Ming874/bsis-radar/docs/PROTOCOL.md

# ESP32 ⇄ 網頁通訊協定（韌體 4.x）

ESP32 與網頁之間以**一行一筆的純文字**溝通：`鍵=值` 以空白分隔，每行以 `\n` 結尾。同一套指令也可以從 USB 序列埠（115200 bps）輸入，USB 端輸出的遙測與藍牙完全相同，可直接用同一套工具記錄與分析。

韌體實作：`firmware/SpeedRadar/src/comm/Telemetry.cpp`、`CommandParser.cpp`；網頁實作：`web/src/domain/protocol.ts`。

4.0 起兩顆雷達都是 HLK-LD2451：**測速雷達**斜照路面（取代 3.x 的 DFRobot C4001）、**後方雷達**朝正後方。3.x 與 4.x 的遙測、設定欄位不同，網頁 4.x 只支援韌體 4.x（主版本不同時會提示）。

## 1. 傳輸層：BLE Nordic UART Service

| 項目 | 值 |
| --- | --- |
| 裝置名稱 | `BSIS-Speed`（2.x 以前為 `RadarA-ESP32`） |
| Service | `6E400001-B5A3-F393-E0A9-E50E24DCCA9E` |
| RX（網頁 → ESP32，Write） | `6E400002-B5A3-F393-E0A9-E50E24DCCA9E` |
| TX（ESP32 → 網頁，Notify） | `6E400003-B5A3-F393-E0A9-E50E24DCCA9E` |
| MTU | ESP32 要求 247，實際值由手機決定 |

- ESP32 依協商到的 MTU 把一行切成多個通知（每段最多 MTU − 3 位元組，上限 180），網頁收到 `\n` 才組成一行。
- 一般藍牙序列 App（nRF Connect、Serial Bluetooth Terminal）也能連線並收發相同文字。
- 藍牙**沒有加密**。安裝與校正完成後，可將 `AppConfig.h` 的 `kAllowBleConfig` 改為 `false`：藍牙只能讀資料，修改參數必須經由 USB。

## 2. 遙測（ESP32 → 網頁）

測速雷達每送一個資料框就送一行；雷達沒有資料時每 250 ms 送一行心跳，心跳的 `FN` 不變。LD2451 有目標時連續輸出（頻率待實測，估計約 10 Hz），**沒有目標時約每 1.4 秒才送一個空資料框**。

```text
R=1 RO=0 ST=3 V=5.43 SD=0.12 Q=95 WD=0 FN=1234 N=3 A=-2 RD=2 RV=4.72 S=12 G=5.40 FV=0 DR=1234.5 W=5.51 DW=1240.2 T=812
```

| 欄位 | 意義 | 單位／格式 | 沒有資料時 |
| --- | --- | --- | --- |
| `R` | 測速雷達是否在線（ESP32 收得到 LD2451 的資料） | 0／1 | — |
| `RO` | 測速雷達只接收：指令沒有回覆（LD2451 RX 沒接到 GPIO17），偵測設定寫不進雷達 | 0／1 | `0` |
| `ST` | 估計器狀態，見 §2.1 | 0～5 | `0` |
| `V` | 對地速度（濾波後、已乘校正係數） | m/s，2 位小數 | `-1`（速度未知） |
| `SD` | `V` 的 1σ 不確定度（卡爾曼濾波的共變異數） | m/s | `0` |
| `Q` | 最近 20 個資料框中可用量測（採用）的比例 | % | `0` |
| `WD` | 最近 20 個資料框中「方向相反」的比例；持續偏高代表 `DIR` 可能設反 | % | `0` |
| `FN` | 資料框序號（開機起累計） | 整數 | — |
| `N` | 這個資料框的目標數（LD2451 最多 5 個「移動中」的目標） | 0～5 | `0` |
| `A` | 代表目標的水平角（0 = 視軸） | 度，整數 | `0` |
| `RD` | 代表目標的距離 | m，**整數** | `-1` |
| `RV` | 代表目標的徑向速度：**正 = 遠離雷達**（朝後安裝、往前騎時的路面） | m/s，2 位小數（雷達的解析度是 1 km/h） | `0` |
| `S` | 代表目標的訊噪比 | 整數 | `0` |
| `G` | 這個資料框換算的對地速度（濾波前；多個路面目標時是中位數） | m/s | `-1`（沒有換算） |
| `FV` | 這個資料框的判斷結果，見 §2.2 | 0～8 | `1` |
| `DR` | 雷達里程（開機起） | m，1 位小數 | — |
| `W` | 輪速感測器的速度（參考值） | m/s | 開機後沒收過脈衝時不送 |
| `DW` | 輪速感測器的里程（圈數 × 輪周長） | m | 同上 |
| `T` | ESP32 開機後經過的時間 | s | — |

**代表目標**：方向正確、在窗口內的目標取對地速度的中位數，那個目標就是代表（偶數個時取中間兩個的平均，代表目標是訊噪比較高的那個）；沒有的話依序是方向相反、靜止、窗口外的目標中訊噪比最高的（[ALGORITHM.md](ALGORITHM.md) §0.3）。

雷達離線（`R=0`）時 `ST=0`、`V=-1`、`RO=0`，不送過時的原始值；`W`／`DW` 與雷達無關，照常送出。最長的一行約 150 位元組，韌體緩衝區 176 位元組（單元測試會檢查）。

### 2.1 估計器狀態 `ST`

| 值 | 名稱 | 意義 | `V` |
| --- | --- | --- | --- |
| 0 | NoRadar | 雷達離線或尚未有資料 | `-1` |
| 1 | Stopped | 靜止 | `0` |
| 2 | Acquiring | 剛看到地面回波，確認中（1 秒內 3 筆一致才開始追蹤） | `0` |
| 3 | Tracking | 正常追蹤 | 估計值 |
| 4 | Holding | 短暫失去地面回波，沿用估計值（最多 2 秒） | 估計值 |
| 5 | Lost | 訊號中斷 | `-1` |

3.x 的 `6`（OverRange，超過 C4001 測速上限）在 4.0 拿掉：LD2451 可量到 120 km/h，不會折疊。

### 2.2 資料框判斷 `FV`

| 值 | 名稱 | 意義 |
| --- | --- | --- |
| 0 | Accepted | 採用，用來更新速度 |
| 1 | NoTarget | 雷達沒有回報目標 |
| 3 | OutOfGate | 目標都不在地面窗口內：距離超出窗口，或水平角超過 ±30° |
| 4 | WrongDirection | 窗口內的目標都和 `DIR` 預期的方向相反（後方來車，或 `DIR` 設反） |
| 5 | Static | 靜止回波（0 km/h），或停著時的微小晃動 |
| 7 | Outlier | 與目前估計相差超過 3σ 閘門 |
| 8 | Acquiring | 擷取階段的量測 |

`2`（Repeated，C4001 的外插資料框）、`6`（AtLimit，接近 `VMAX`）、`9`（Unfolded，折疊還原）是 3.x 才有的，4.0 不再出現。LD2451 的速度是整數 km/h，連續幾個資料框完全一樣很正常，不再當作外插。

### 2.3 後方來車（`REAR` 行，韌體 3.1 起）

後方 LD2451 的狀態另外一行，和上面的遙測分開送（每行都放得進一個藍牙通知）：有目標或警示中每 0.1 秒、沒有目標時每 0.5 秒、後方雷達離線時每 1 秒（`REAR ON=0`），**等級改變時立刻送**。`AppConfig.h` 的 `kPinRearRx = -1`（沒有後方雷達）時完全不送。

```text
REAR ON=1 RO=0 LV=1 D=12.4 V=4.17 TTC=3.0 HOLD=0 N=2 CNT=3 FN=812 X=-3/12/15,6/31/-40
```

| 欄位 | 意義 | 單位／格式 | 沒有資料時 |
| --- | --- | --- | --- |
| `ON` | 後方雷達在線（ESP32 收得到 LD2451 的資料框） | 0／1 | — |
| `RO` | 只接收：LD2451 不回應指令（RX 沒接），偵測設定沒寫進雷達 | 0／1 | `0` |
| `LV` | 警示等級：0 安全、1 注意、2 危險（[REAR_RADAR.md](REAR_RADAR.md) §5） | 0～2 | `0` |
| `D` | 主要來車的距離（濾波後） | m，1 位小數 | `-1` |
| `V` | 主要來車的接近速度（都卜勒） | m/s，2 位小數 | `0` |
| `TTC` | 主要來車的到達時間 | s，1 位小數 | `-1` |
| `HOLD` | 警示保持中：來車已不在雷達視野（正在旁邊超車，或停下來了） | 0／1 | `0` |
| `N` | 這個資料框的目標數（LD2451 最多 5 個） | 0～5 | `0` |
| `CNT` | ESP32 開機後的警示次數（安全 → 注意／危險算一次），網頁用差值算每趟行程的次數 | 整數 | — |
| `FN` | 後方雷達資料框序號（開機起） | 整數 | — |
| `X` | 這個資料框的每個目標：`角度/距離/速度`，以逗號分隔。角度 °（0 = 正後方）、距離 m、速度 km/h（**正 = 靠近、負 = 遠離**） | 整數 | 沒有目標時不送 |

`ON=0` 時只有這一個欄位。LD2451 的距離、速度、角度都是整數（雷達本身的解析度）。最長的一行約 150 位元組。注意 `REAR` 的 `X` 速度是「正 = 靠近」，主遙測的 `RV` 是「正 = 遠離」：兩者各自沿用 3.x 的定義。

## 3. 設定（ESP32 → 網頁）

回應 `GET`，以及每次設定成功後主動廣播一次：

```text
CFG ANGLE=30.0 HEIGHT=0.70 DIR=1 MODEL=0 CAL=1.0000 GSNR=4 WHEEL=2105 RMIN=0.71 RMAX=8.13 RANGE=15 RSPD=5 TTC=2.5 RSNR=4 RDET=25 FW=4.0.0
```

| 欄位 | 指令 | 意義 | 範圍 | 預設 |
| --- | --- | --- | --- | --- |
| `ANGLE` | `ANGLE <度>` | 測速雷達視軸的俯角（與水平面的夾角） | 10～75 | 30 |
| `HEIGHT` | `HEIGHT <m>` | 測速雷達天線面中心的離地高度 | 0.15～1.50 | 0.70 |
| `DIR` | `DIR 1\|-1` | 雷達朝向：`1` 朝後（往前騎時地面遠離）、`-1` 朝前 | 1／-1 | 1 |
| `MODEL` | `MODEL 0\|1` | 速度模型：`0` 固定角度、`1` 距離幾何（[ALGORITHM.md](ALGORITHM.md) §0.4） | 0／1 | 0 |
| `CAL` | `CAL <係數>` | 校正係數，速度與里程都乘上它 | 0.5～2.0，4 位小數 | 1.0000 |
| `GSNR` | `GSNR <n>` | 測速雷達（LD2451）的訊噪比門檻，越大越不靈敏（寫進雷達） | 3～8 的整數 | 4 |
| `WHEEL` | `WHEEL <mm>` | 輪周長，只用於輪速感測器（參考值） | 1000～3000 的整數 | 2105 |
| `RMIN`／`RMAX` | — | 由 `ANGLE`、`HEIGHT` 算出的地面距離窗口（唯讀）；LD2451 的距離是整數，韌體實際用 ⌊`RMIN`⌋～⌈`RMAX`⌉ | m | — |
| `RANGE` | `RANGE <m>` | 後方來車警示距離：確認的來車在這個距離內 → 注意 | 5～50 的整數 | 15 |
| `RSPD` | `RSPD <km/h>` | 後方來車最低接近速度（寫進後方 LD2451，ESP32 也再篩一次） | 1～30 的整數 | 5 |
| `TTC` | `TTC <s>` | 到達時間 ≤ TTC（或距離 ≤ 5 m）→ 危險 | 1.0～6.0，1 位小數 | 2.5 |
| `RSNR` | `RSNR <n>` | 後方 LD2451 的訊噪比門檻，越大越不靈敏（寫進雷達） | 3～8 的整數 | 4 |
| `RDET` | — | 寫進後方 LD2451 的最大偵測距離 = `RANGE` + 10（10～100，唯讀） | m | 25 |
| `FW` | — | 韌體版本 | — | — |

寫進測速雷達的其他偵測設定是固定的：最大距離 10 m（可設定的最小值）、**靠近遠離都回報**（方向由 ESP32 依 `DIR` 判斷，設反時網頁才看得出來）、最低速度 1 km/h、延遲 1 s、累計觸發 1 次。

- 參數存在 ESP32 的 NVS（命名空間 `speedRadar`），斷電不會消失。對地測速欄位的版本：4.0 是 `ver=2`。從 3.x（`ver=1`，C4001）升級時沿用 `ANGLE`、`HEIGHT`、`DIR`、`WHEEL`；`CAL` 回到 1（換了雷達要重新校正），`MODEL`、`GSNR` 用預設值，C4001 的 `RTHR`、`VMAX` 在下次存檔時刪除。後方來車參數（3.1 新增）另外記版本，不受影響。
- 修改 `GSNR` 時 ESP32 會重新寫入測速雷達；修改 `RANGE`、`RSPD`、`RSNR` 時重新寫入後方雷達（各約 1 秒內沒有資料框）。只接收模式（`RO=1`）寫不進去。改 `ANGLE`、`HEIGHT` 只影響 ESP32 的換算與窗口，不必重寫雷達。
- 沒有 `RANGE` 的 `CFG` 是 3.0 的韌體（沒有後方雷達功能）。

## 4. 指令（網頁 → ESP32）

一行一個指令，大小寫不拘，數值可用空白、`=` 或 `:` 分隔，以 `\n` 結尾。

| 指令 | 作用 |
| --- | --- |
| `GET` | 回傳一行 `CFG` |
| `ANGLE 30`、`HEIGHT 0.7`、`DIR -1`、`MODEL 1`、`CAL 1.0425`、`GSNR 4`、`WHEEL 2105` | 修改單一參數（對地測速） |
| `RANGE 15`、`RSPD 5`、`TTC 2.5`、`RSNR 4` | 修改單一參數（後方來車） |
| `DEFAULTS` | 所有參數恢復預設值 |
| `REBOOT` | 重新啟動 ESP32 |
| `HELP` 或 `?` | 列出所有指令 |

3.x 的 `RTHR`、`VMAX` 在 4.0 回覆 `ERR unknown command`。

### 指令回覆

| 回覆 | 時機 |
| --- | --- |
| `OK saved` | 設定成功並已存檔，接著廣播一行 `CFG` |
| `OK applied (flash save failed)` | 已生效，但寫入快閃記憶體失敗（重開機會還原） |
| `OK reboot` | 收到 `REBOOT`，約 0.2 秒後重新開機 |
| `OK commands: …` | `HELP` 的指令列表 |
| `ERR <參數> must be <範圍>` | 數值超出範圍或格式錯誤（例如 `ERR ANGLE must be 10-75 (deg)`） |
| `ERR missing or bad value` | 缺少數值，或數值後面有多餘文字 |
| `ERR settings over Bluetooth are disabled, use USB` | `kAllowBleConfig = false` 時從藍牙修改參數 |
| `ERR unknown command, try HELP` | 不認得的指令 |

## 5. 解析規則

- 以空白切成 `鍵=值`；**不認得的鍵直接忽略**，之後新增欄位不會破壞舊的接收端。
- 同一行出現重複的鍵代表兩行被黏在一起（藍牙分段遺失），整行丟棄。
- 數值一律使用小數點、不含單位；`-1` 代表「沒有資料」（`V`、`RD`、`G`）。
- 開頭為 `CFG` 的是設定，`REAR` 是後方來車，`OK`／`ERR` 是指令回覆，其他含 `R`、`ST`、`V` 的是遙測。
- 判斷韌體世代：`CFG` 含 `TEST=`、`MINSPD=` 的是 2.x（後方來車偵測版），網頁會提示更新韌體；`FW` 的主版本與網頁不同（例如 3.x 的 C4001 版）時網頁也會提示。

## 6. CSV 紀錄格式（網頁「數據 → 記錄 CSV」）

每一個新的資料框一列（心跳行不重複記錄），UTF-8 含 BOM，Excel 可直接開啟。欄位與遙測一一對應：

```text
time_iso,uptime_s,frame,radar_online,state,speed_mps,sigma_mps,quality_pct,targets,angle_deg,range_m,radial_mps,snr,ground_mps,verdict,radar_distance_m,wheel_mps,wheel_distance_m,rear_online,rear_level,rear_distance_m,rear_closing_mps,rear_ttc_s,rear_targets
```

`state` 與 `verdict` 以名稱表示（`tracking`、`accepted`…）。`angle_deg`、`range_m`、`radial_mps`、`snr` 是代表目標（§2）。網頁 3.x 的 CSV 在 `radial_mps` 後面是 C4001 的 `energy`，4.0 改成 `snr`，並在 `range_m` 前面多了 `angle_deg`。`rear_*` 是那一刻最新的 `REAR` 行（網頁 3.1 起）：`rear_level` 為 `safe`／`caution`／`danger`，`rear_targets` 是以空白分隔的 `角度/距離/速度`。分析工具：[`firmware/diagnostics/analyze_ride.py`](../firmware/diagnostics/README.md)。

## 7. 網頁的匯出檔

這兩種檔案只在網頁產生，不經過 ESP32。

**行程紀錄**（「行程」頁的匯出，CSV，UTF-8 含 BOM）：一筆行程一列。

```text
start_iso,end_iso,distance_m,moving_s,elapsed_s,avg_kmh,max_kmh,overspeed_count,overspeed_s,limit_kmh,wheel_distance_m,rear_alerts
```

`avg_kmh` 是里程 ÷ 移動時間；沒有的欄位留空（網頁 2.1 以前的行程沒有超速，3.0 以前沒有 `limit_kmh`，3.1 以前沒有 `rear_alerts`）。

**一筆行程的速度曲線**（行程詳情的匯出，CSV）：`elapsed_s,speed_kmh`。每一格是那段時間的平均速度，間隔從 1 秒開始，點數到 900 時兩兩合併、間隔加倍（一小時的行程是 4 秒一格）；藍牙中斷的那幾格留空。

**備份檔**（「設定 → 資料 → 匯出備份」，JSON）：

```json
{ "app": "bsis-speed", "version": 1, "exportedAt": 1792000000000, "webVersion": "4.0.0",
  "settings": { "speedUnit": "kmh", "speedLimitKmh": 25, "...": "..." },
  "trips": [ { "id": "…", "startedAt": 0, "endedAt": 0, "distanceM": 0, "movingS": 0, "maxMps": 0, "rearAlerts": 3, "trace": { "stepS": 1, "v": [512, -1, 530] } } ] }
```

`trace.v` 是 cm/s 的整數，`-1` 代表那一格沒有資料。匯入時逐筆檢查：格式不對的行程略過；設定只取認得的欄位；行程依 `id` 合併，不會重複。網頁 3.1 以前的備份檔另有 `calibration`（校正紀錄），3.2 起網頁不做校正，匯入時忽略。
