Ming874/bsis-radar/firmware/release/VERSION.txt

BSIS SpeedRadar v4.0.0
built   : 2026-11-11 19:45
board   : esp32:esp32:esp32 (ESP32 Dev Module)
flash   : bootloader.bin@0x1000 partitions.bin@0x8000 boot_app0.bin@0xe000 firmware.bin@0x10000
sha256  : 0d4cd2b93d181d13e13b93b3a1d2856e8062967ea8cf7ff9ffbece83a566587c (firmware.bin)
