Ming874/bsis-radar/docs/images/desktop-device.png

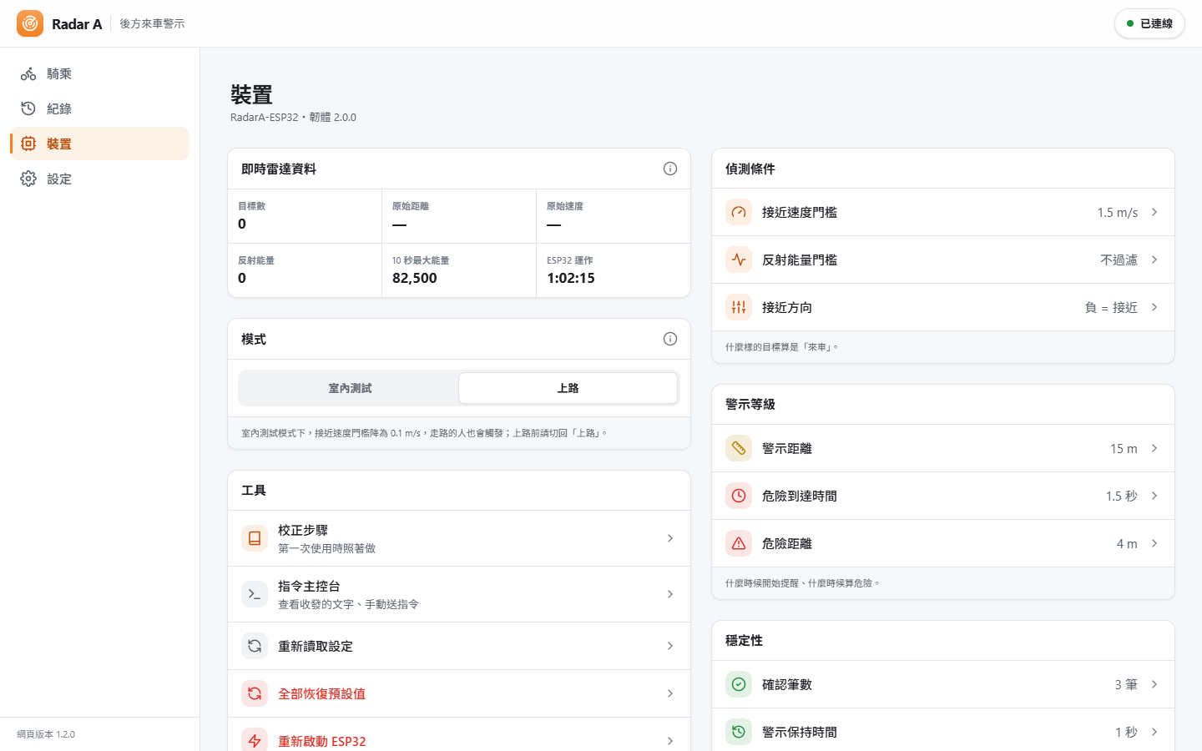
docs/images/desktop-device.png
