Ming874/bsis-radar/docs/images/desktop-ride.png

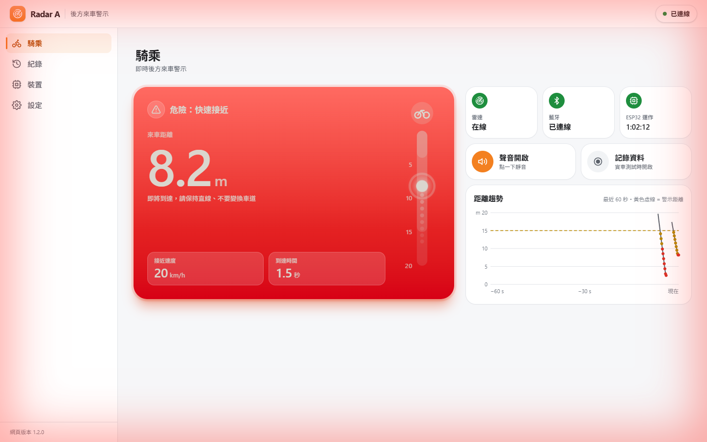
docs/images/desktop-ride.png
