Ming874/bsis-radar/docs/images/phone-caution.png

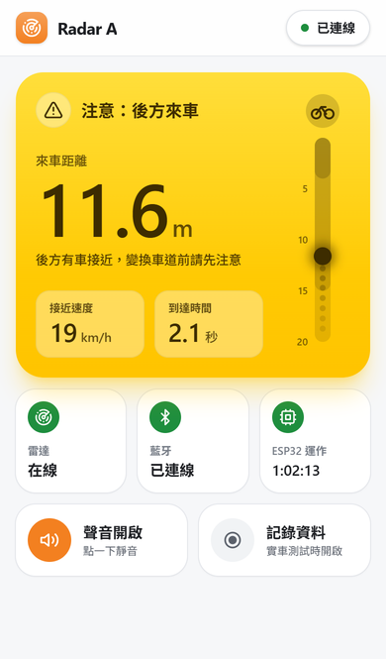
docs/images/phone-caution.png
