Ming874/bsis-radar/docs/images/phone-danger-dark.png

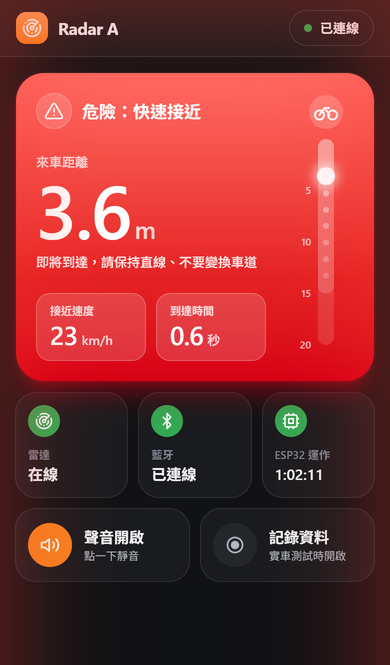
docs/images/phone-danger-dark.png
