Ming874/bsis-radar/docs/images/phone-danger.png

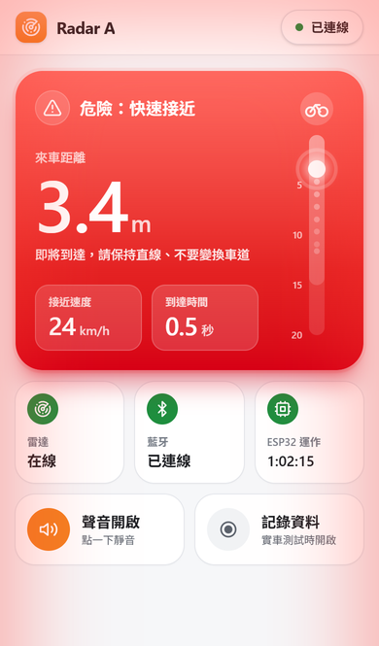
docs/images/phone-danger.png
