Ming874/bsis-radar/firmware/SpeedRadar/src/comm/Telemetry.h

/*!
 * @file   Telemetry.h
 * @brief  【通訊層】傳給網頁的文字格式（純 C++，可單元測試）。完整欄位定義見 docs/PROTOCOL.md。
 *
 * 遙測：測速雷達每一個資料框送一行；雷達沒有資料時每 250 ms 送一行心跳（FN 不變）。
 *   R=1 RO=0 ST=3 V=5.43 SD=0.12 Q=95 WD=0 FN=1234 N=3 A=-2 RD=2 RV=4.72 S=12 G=5.40 FV=0 DR=1234.5 W=5.51 DW=1240.2 T=812
 *   R  測速雷達在線    RO 測速雷達只接收（指令沒有回覆，偵測設定沒寫進雷達）
 *   ST 估計器狀態（SpeedState）   V 對地速度 m/s（未知 -1）   SD 1σ 不確定度 m/s
 *   Q  最近 20 筆可用量測比例 %   WD 最近 20 筆方向相反的比例 %   FN 資料框序號
 *   N  這個資料框的目標數
 *   A/RD/RV/S 代表目標的水平角° / 距離 m（整數） / 徑向速度 m/s（正 = 遠離雷達） / 訊噪比（沒有目標時 0 / -1 / 0 / 0）
 *   G  這個資料框換算的對地速度（濾波前，沒算 -1）   FV 這個資料框的判斷（FrameVerdict）
 *   DR 雷達里程 m（開機起）   W/DW 輪速感測器的速度 m/s / 里程 m（收過脈衝才送）   T 開機秒數
 *
 * 後方來車（HLK-LD2451，另外一行；有目標或警示中每 0.1 秒、平常每 0.5 秒、等級改變時立刻送）：
 *   REAR ON=1 RO=0 LV=1 D=12.4 V=4.17 TTC=3.0 HOLD=0 N=2 CNT=3 FN=812 X=-3/12/15,6/31/40
 *   ON 雷達在線   RO 只接收（指令沒有回覆，設定沒寫進雷達）   LV 警示等級（RearLevel）
 *   D/V/TTC 主要來車的距離 m / 接近速度 m/s / 到達時間 s（沒有為 -1 / 0 / -1）   HOLD 警示保持中
 *   N 這個資料框的目標數   CNT 開機後的警示次數   FN 後方雷達資料框序號
 *   X 這個資料框的目標：角度°/距離 m/速度 km/h（正 = 靠近、負 = 遠離），以逗號分隔（沒有目標時不送）
 *
 * 設定：CFG ANGLE=30.0 HEIGHT=0.70 DIR=1 MODEL=0 CAL=1.0000 GSNR=4 WHEEL=2105 RMIN=0.71 RMAX=8.13
 *           RANGE=15 RSPD=5 TTC=2.5 RSNR=4 RDET=25 FW=4.0.0（實際是一行）
 *   RMIN/RMAX 是由 ANGLE、HEIGHT 算出的地面距離窗口、RDET 是寫進後方 LD2451 的偵測距離（RANGE + 10），都是唯讀
 *
 * 每行以 '\n' 結尾；藍牙依 MTU 分段送出，網頁端收到 '\n' 才算一行。最長的一行也放得進一個通知（單元測試會檢查）。
 */
#pragma once
#include <stddef.h>
#include <stdint.h>

#include "../core/GroundSpeedEstimator.h"
#include "../core/RadarFrame.h"
#include "../core/RearThreat.h"
#include "../core/SpeedConfig.h"

// 一行文字的緩衝區大小（含結尾 '\n' 與 '\0'）；單元測試會檢查最長的情況放得下
constexpr size_t kTelemetryLineMax = 176;
constexpr size_t kConfigLineMax    = 176;
constexpr size_t kRearLineMax      = 176;

struct TelemetrySnapshot {
  bool        radarOnline  = false;
  bool        receiveOnly  = false;  // 測速雷達只接了 TX：偵測設定寫不進去
  SpeedState  state        = SpeedState::NoRadar;
  bool        hasSpeed     = false;
  float       speedMps     = 0.0f;
  float       sigmaMps     = 0.0f;
  uint8_t     qualityPct   = 0;
  uint8_t     wrongDirPct  = 0;
  uint32_t    frame        = 0;      // 資料框序號（心跳時不變，網頁用來去除重複）
  bool        hasFrame     = false;  // 有沒有最新一個資料框
  RadarFrame  raw;
  FrameResult result;
  double      radarDistanceM = 0.0;
  bool        hasWheel       = false;  // 有接輪速感測器（開機後收過脈衝）
  float       wheelMps       = 0.0f;
  double      wheelDistanceM = 0.0;
  uint32_t    uptimeS        = 0;
};

struct RearSnapshot {
  bool       online      = false;
  bool       receiveOnly = false;
  RearState  state;
  uint32_t   frame    = 0;      // 後方雷達資料框序號
  bool       hasFrame = false;  // 有沒有最新（1 秒內）的資料框
  RadarFrame raw;
};

// 回傳寫入的字元數（含結尾 '\n'），空間不足時回傳 0
size_t formatTelemetry(const TelemetrySnapshot& s, char* out, size_t cap);
size_t formatRear(const RearSnapshot& s, char* out, size_t cap);
size_t formatConfig(const SpeedConfig& c, const char* firmwareVersion, char* out, size_t cap);
