Ming874/bsis-radar/(commit log)

2026-10-03 Radar A 後方來車偵測：ESP32 韌體與網頁
    - 韌體 v2.0.0：非阻塞 C4001 驅動、來車確認與 TTC 分級、BLE NUS、NVS 設定、一鍵燒錄 flash.bat
    - 網頁 v1.2.0：React + TypeScript + Vite，白底橘色主題、iOS 風格警示卡、手機／電腦版自動切換
    - 文件：上手文件、通訊協定、韌體與網頁說明
2026-10-03 部署改為 GitHub 自動更新：push 到 main 由 Zeabur 自動建置 web/
2026-10-03 網頁預設改為深色主題
    - 預設主題改為深色（設定存放名稱改為 radarA.settings.v3，舊的偏好不沿用）
    - index.html 在畫面出現前就套用主題，網址列顏色同步
    - 設定頁外觀選項把「深色」放第一個
2026-10-03 韌體 v2.1.0：都卜勒 × 距離變化率交叉核對的來車速度演算法
    - 卡爾曼濾波器（距離、距離變化率）融合雷達距離與都卜勒速度，取代原本的 α 濾波
    - 以最近 1 秒距離的最小平方斜率核對都卜勒：超過 10 m/s 的折疊自動還原、SIGN 設反自動修正並提示、
    速度飽和或不一致時改用距離變化率；具遲滯與正負號鎖定，避免誤判
    - 驗證閘門依卡爾曼不確定度調整；連續 3 筆彼此一致的跳值才換目標，反射點亂跳不會帶偏追蹤
    - 遙測新增 VS（速度來源）與 RR（距離變化率）；序列埠除錯輸出同步顯示
    - 單元測試 173 項（新增折疊、飽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
    [AppConfig.h, Telemetry.cpp, Telemetry.h]
2026-10-03 修正 CLAUDE.md 的指令文字
2026-10-15 韌體 v2.2.0：依 C4001 實測修正偵測不穩（雷達門檻 30 → 5）
    用 USB ↔ 雷達直通程式實測 C4001（10 Hz、室內、人坐在雷達前 0.5～1 m）找到的問題：
    - setThrFactor 一直用 30，但 UART 的數字就是門檻本身（讀回 30.00），原廠預設是 5：
    門檻 30 時 30 秒只有 4% 的資料有目標（而且是 3.2 m 外風扇的雜訊），5／10／15 都是 100%，
    逐筆距離變化 1.2～4.2 cm。雷達門檻改成執行期參數 RTHR（1～50，預設 5），網頁可調
    - 能量中位數把「0 個目標」算成 0：目標斷斷續續時中位數變 0，設了 MINE 就確認不了來車；
    現在只統計追蹤中目標的偵測，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
2026-10-15 新增 C4001 診斷工具（firmware/diagnostics）
    - C4001Bridge：USB ⇄ C4001 直通程式，可直接下指令、記錄每一筆原始資料框（ALGORITHM.md §10 的實測方法）
    - bridge.ps1／analyze.awk：送指令並記錄、統計偵測率、外插資料框與距離／速度／能量
    - guided_test.ps1：搭配正式韌體，用中文語音引導走動測試，逐輪比較不同的 RTHR
2026-10-15 網址改為 bsis.mingchen.dev
    網頁、flash.ps1 的提示、README、上手文件與 CLAUDE.md 的正式網址從 bsis.iosoftware.ai 改成 bsis.mingchen.dev。
2026-10-15 文件：走動測試結果（雷達門檻 5／15／30）
    語音引導走動測試：門檻 5 走動時偵測率 100%、距離沒有跳動；15 為 96.7%、跳動 4 次；
    舊版 30 只有 76.8%、跳動 14 次（最遠跳到 6.9 m）。
2026-10-15 韌體 v2.3.0／網頁 v1.5.0：沒有來車時也顯示雷達追蹤中的目標
    人站在雷達前面不動時，雷達其實一直追蹤得到（實測 64 筆有 63 筆），但網頁只顯示
    「確認正在接近的來車」，所以看起來只偵測到一下下就跳回安全，卡片還寫「後方淨空」。
    - 遙測新增 TD／TV：雷達目前追蹤的目標距離與接近速度（濾波後，不論是不是來車；沒有追蹤時不送）
    - 騎乘頁：安全時卡片下方顯示「偵測到目標 2.9 m・靜止／接近／遠離」，雷達條上畫空心圈；
    大數字與警示仍然只給確認的來車
    - 裝置頁：即時雷達資料加入「追蹤距離」「追蹤速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
2026-10-15 更正：正對雷達的牆會被回報成靜止目標
    實測雷達朝著約 2.9 m 外的牆、前方沒有人時，一直回報 2.86 m、速度 ≈ 0 的目標：
    門檻 5 時 100%、門檻 30 仍有 93%（同一門檻下坐在 0.45 m 的人是 0%），所以是牆，不是人。
    先前「靜止物體（牆、停著的車）不會出現」的說法不對，改正文件與網頁說明：
    - 大部分靜止物體不回報，但正對的牆會；靜止目標不會警示
    - 雷達一次只回報一個目標，牆的反射可能蓋過站在牆前的人：室內測試請朝向空曠方向
    - 走動測試的解讀一併修正（離開階段約 2.5 m 的固定目標應該是牆）
    - 上手文件的問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
2026-10-19 韌體 v2.4.0／網頁 v1.6.0：用輪速霍爾感測器量自身車速（取代缺貨的 Radar B）
    - 3144 霍爾開關（或磁簧開關）接 GPIO27、輻條上一顆磁鐵：WheelSensor 用下降緣中斷記下時間，
    WheelSpeed 算車速（輪周長 ÷ 最近兩圈平均間隔；減速時平順下降、3 秒沒脈衝算停止、40 ms 內的脈衝當雜訊）
    - 遙測行尾加上 S=<km/h>；開機後收到第一個脈衝才送，沒接感測器時網頁不會顯示假的 0 km/h
    - 新參數 WHEEL（輪周長 1000～3000 mm，預設 2105＝700×25C），網頁裝置頁「自身車速」可調，附量法與對照表
    - 騎乘頁標題改為「自身車速」；序列埠除錯輸出加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
2026-10-20 韌體 v3.0.0／網頁 v2.0.0：C4001 改為斜照路面量對地速度
    雷達的用途由後方來車偵測改為自行車對地測速（後方來車改由另一套倒車雷達負責）。
    2.x 的後方來車版保留在 commit 8a5c3b6。
    韌體（firmware/SpeedRadar，原 RadarA_C4001_BLE）
    - GroundSpeedEstimator：逐筆有效性判斷（地面距離窗口、方向、外插框、靜止回波、
    測速上限）、折疊還原、等加速度卡爾曼濾波（二階差分估計量測雜訊、依 NIS 切換
    過程雜訊）、靜止／擷取／追蹤／保持／中斷狀態機、以量測值積分里程
    - C4001 測速上限不確定（規格 3 或 10 m/s）：VMAX 預設 3.28、依預測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
2026-10-20 修正文件章節參照（程式註解與文件之間）
2026-10-22 網頁 v2.1.0：超速警示（預設 25 km/h）
    對地速度持續 0.5 秒達到速限時，速度數字與外框變紅、頂端列顯示「超速」、
    響兩聲並震動；降到速限 − 1 km/h 以下 1 秒後解除。只改網頁，韌體不變。
    判斷（domain/overspeed.ts，純函式）
    - 只用雷達的估計值；靜止、擷取、中斷、雷達離線、藍牙資料中斷時立即解除
    - 「超出測速上限」只有在不折疊的最高速度 ≥ 速限時才視為超速
    - 遲滯 1 km/h、進入 0.5 秒、解除 1 秒；提示音冷卻 5 秒
    畫面與設定
    - 速度頁：速限提示、紅色數字與外框；趨勢圖加速限線、超過的那段改紅色
    - 行程：超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
2026-10-23 網頁：vite 升到 8.3.5，修補高風險安全漏洞（launch-editor 指令注入、server.fs 繞過等）
2026-11-03 feat: implement rear alert system with Zustand store and UI components
    - Add rearAlertStore for managing rear alert state and cues.
    - Implement stepRearCue logic for determining alert levels based on telemetry data.
    - Create rear.ts for domain logic related to rear alerts, including alert timing and speech content.
    - Develop RearPanel component for calibrating rear radar settings.
    - Create RearCard component to display rear vehicle information and alerts.
    - Implement RearRadar and RearStrip components for visual representation of rear radar data.
    - Add tests for rear alert logic and functionality.
2026-11-03 docs: enhance HLK-LD2451 wiring instructions for clarity and safety
2026-11-10 docs: 部署說明改為 Mac 上自架的 Zeabur（mac-a） (#2)
2026-11-10 網頁 v3.2.0：拿掉校正係數與精度驗證（沒有使用輪速感測器）
    - 校正頁只留設定進度、安裝幾何、後方雷達；設定進度拿掉「校正係數」與「輪速感測器」兩項
    - 移除 calibrationStore、domain/calibration（距離／輪速校正、多趟合併、精度驗證的比對）
    - 速度頁「量測設定」不再顯示 CAL；設定頁拿掉「尚未校正」提示，維護與資料的文字一起更新
    - 備份檔不再包含校正紀錄；3.1 以前的備份檔照樣能匯入（calibration 欄位忽略）
    - 韌體仍套用 ESP32 存的 CAL；上手文件 §9 改成用已知距離手動計算、從主控台送 CAL 指令
    - 更新校正頁與電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
2026-11-10 網頁：舊校正紀錄的 localStorage 鍵名常數改名，避開 gitleaks generic-api-key 誤判
    LEGACY_CALIBRATION_KEY = 'bsis.calibration.v1'（名稱含 KEY、字串熵約 3.58 > 3.5）
    被 CI 的 secret scan 當成 API key，擋住了 v3.2.0 的上線。
2026-11-11 chore: 觸發重新建置（bsis.mingchen.dev 回 404／400，容器內的網頁檔讀不到）
2026-11-11 韌體／網頁 4.0：測速雷達從 C4001 換成 HLK-LD2451
    兩顆雷達都是 HLK-LD2451：一顆斜照路面測速（TX → GPIO16、RX → GPIO17、5 V），一顆朝後偵測來車。
    韌體
    - LD2451Radar 改成可以開兩個實例（名稱、偵測方向可設定）；測速雷達寫入 10 m、靠近遠離都回報、1 km/h、GSNR
    - GroundSpeedEstimator 改吃整個 LD2451 資料框：整數距離窗口、水平角 ±30°、cos φ 修正，方向正確的目標取中位數
    - 拿掉 C4001 驅動與協定、測速上限／折疊還原（VMAX、OverRange、AtLimit、Unfolded）、外插資料框判斷、RTHR
    - 新參數 GSNR（3～8）；ANGLE 範圍 10～75、預設 30；NVS ver=2，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
2026-11-11 退回 3.x：測速改回 C4001，後方來車維持 HLK-LD2451（韌體 3.1.0／網頁 3.2.0）
    Revert "韌體／網頁 4.0：測速雷達從 C4001 換成 HLK-LD2451"（4311516）。
    2026-11-11 實測：LD2451 最近只回報到約 2 m，0.7 m 高、斜 15～45° 照路面幾乎抓不到路面，
    量不出自身速度。韌體、網頁、文件回到 4.0 之前（8411612）；firmware/release/ 是 3.1.0 的預編譯檔，
    雙擊 flash.bat 就能燒進新的 ESP32。4.0 留在分支 ld2451-ground-speed。
    保留 4.0 順便做的工具改進：
    - arduino.ps1：g++ 依序找 PATH → C:\MinGW → WinLibs；新增 devicetest（在 ESP32 上跑單元測試，跑完燒回正式韌體）
    - flash.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
